Vittaly76/Hisense-to-MQTT/Схема/Schematic_ESP Hisense 485_2022-09-16.pdf

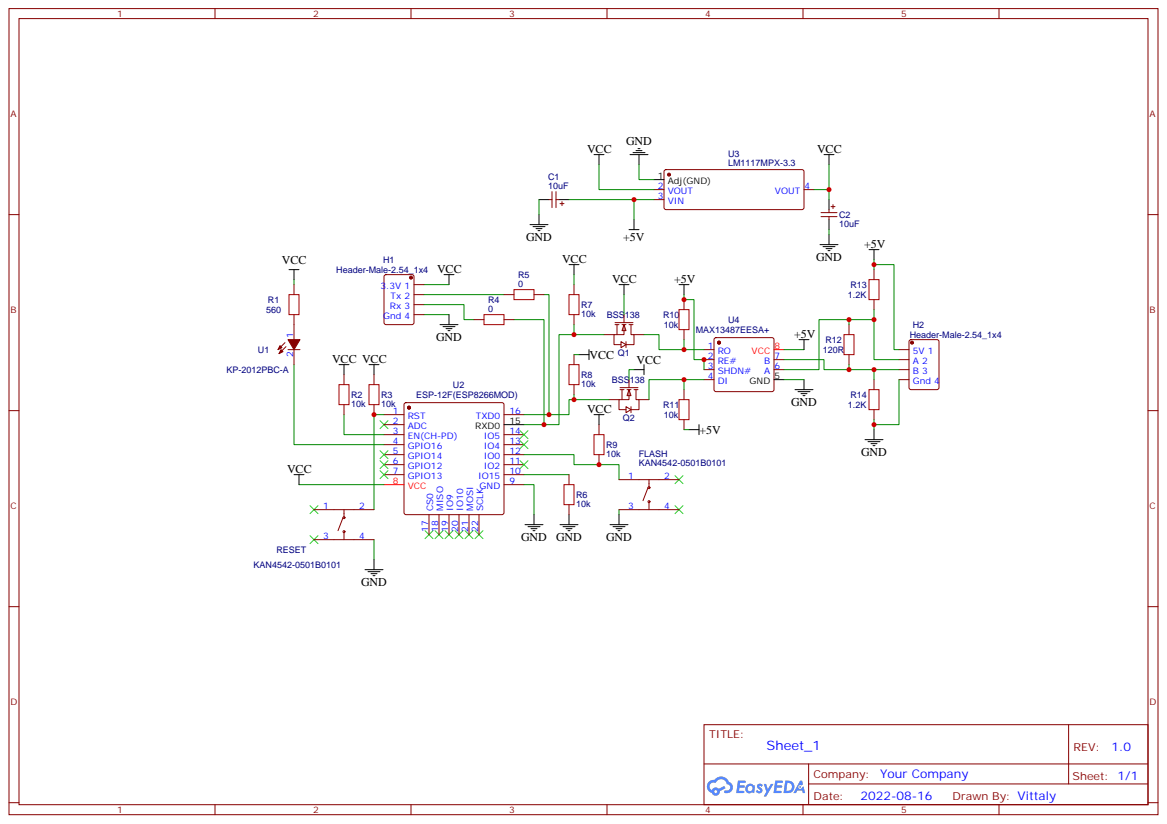
[picture p2: page 1]
