Vittaly76/Hisense-to-MQTT/(list of files, drawings)

Other design files:
плата/PCB_PCB_ESP Hisense 485_2022-09-16.json
Схема/SCH_ESP Hisense 485_2022-09-16.json
