Vittaly76/Hisense-to-MQTT/(threads)

Thread 2 (2024-07-24):

Готовые модули

ai91, 2024-07-24:
Рассматривали ли вы возможность продавать готовые модули?
Я бы с удовольствием купил парочку.

Vittaly76, 2024-07-24:
Увы... К сожалению, у меня нет для этого времени...Но могу консультировать, чтобы помочь собрать

ai91, 2024-07-25:
Было бы здорово. Напишите мне на anar.ibragimoff@gmail.com - я вам скину адрес. И если есть, например, PayPal - его тоже, я также компенсирую стоимость и пересылку в Германию
